shuki25/iot-playground-esp32/pdf/iot_playground.pdf

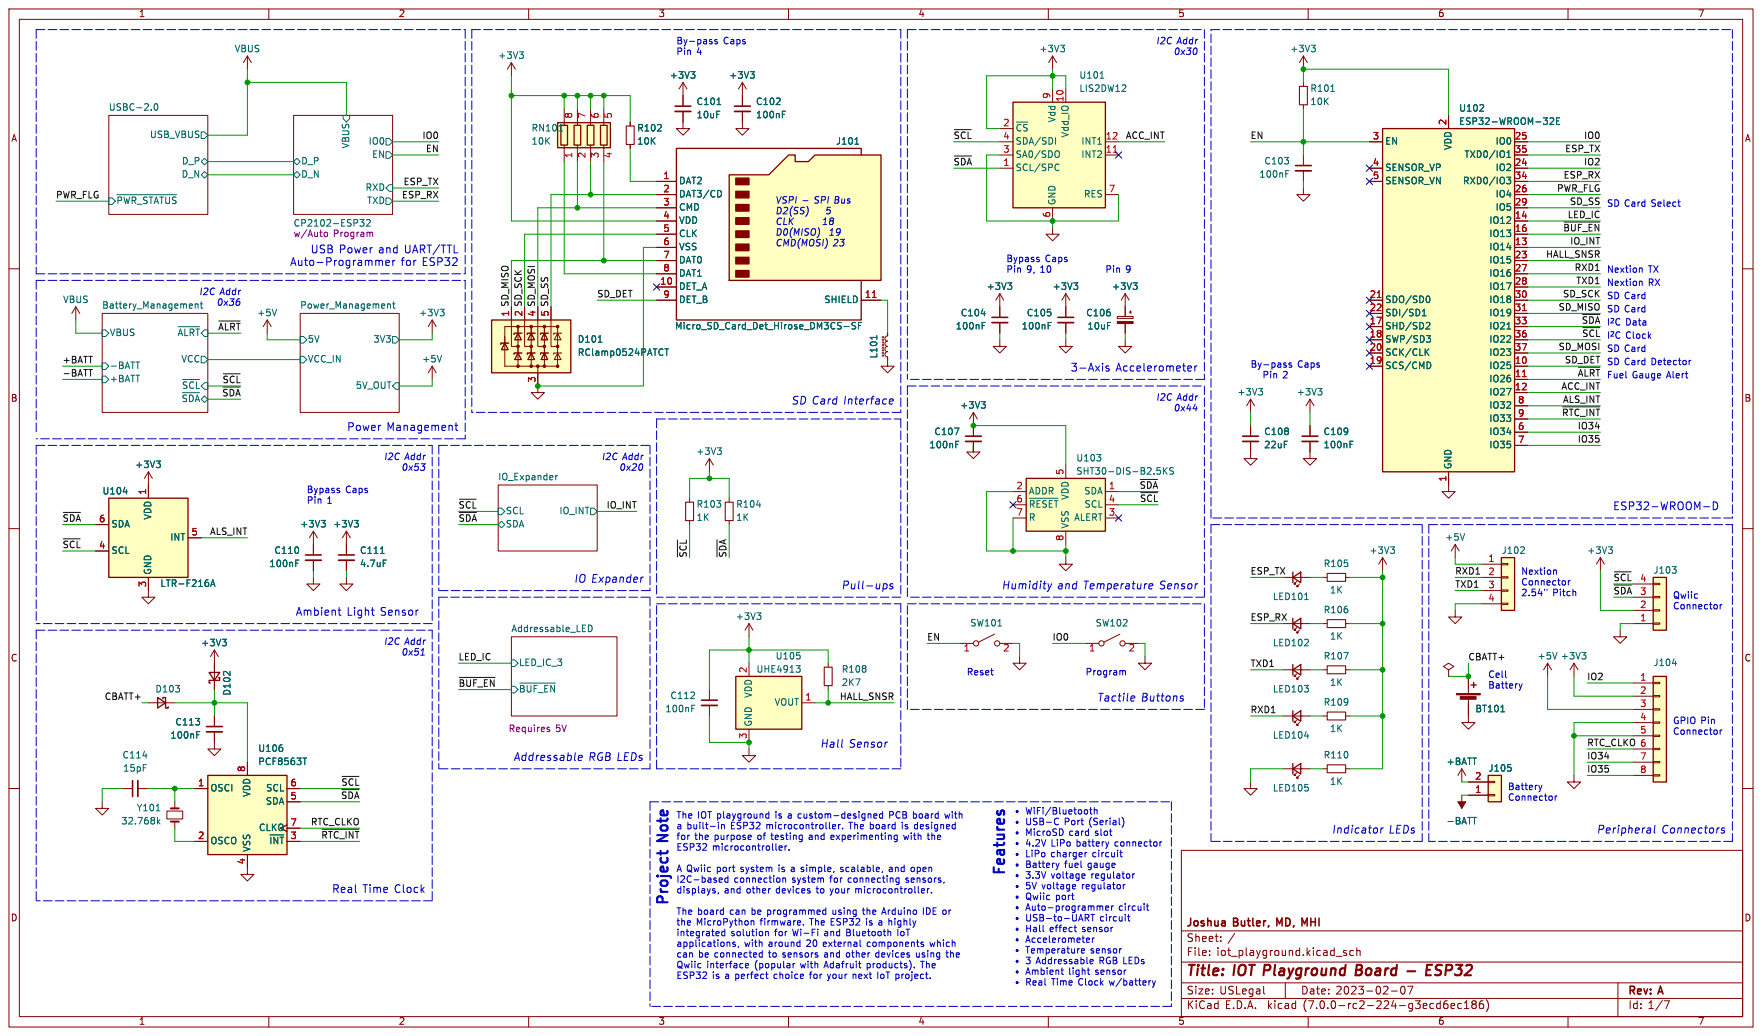
[picture p1: page 1]

4 SDA 5 SCL 6 CLKO 7 VDD

þÿ "WiFi/Bluetooth
þÿ "USB-C Port (Serial)
þÿ "MicroSD card slot þÿ "4.2V LiPo battery connector þÿ "LiPo charger circuit þÿ "Battery fuel gauge

Id: 1/7 Title: IOT Playground Board - ESP32

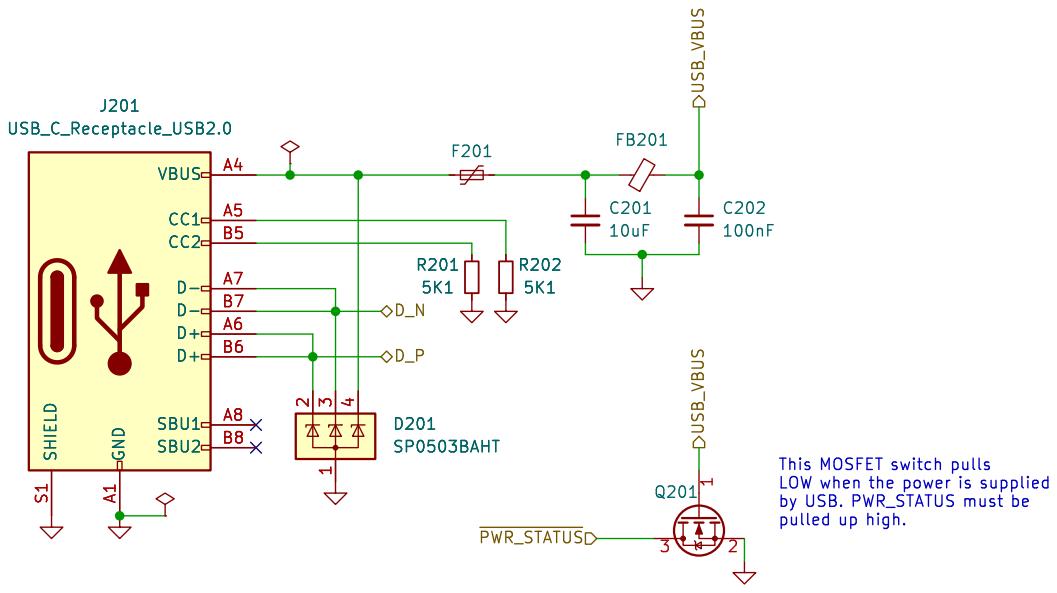
[picture p2: page 2]

This MOSFET switch pulls LOW when the power is supplied

by USB. PWR_STATUS must be

Id: 2/7 Title: USB-C 2.0 / Power and Data

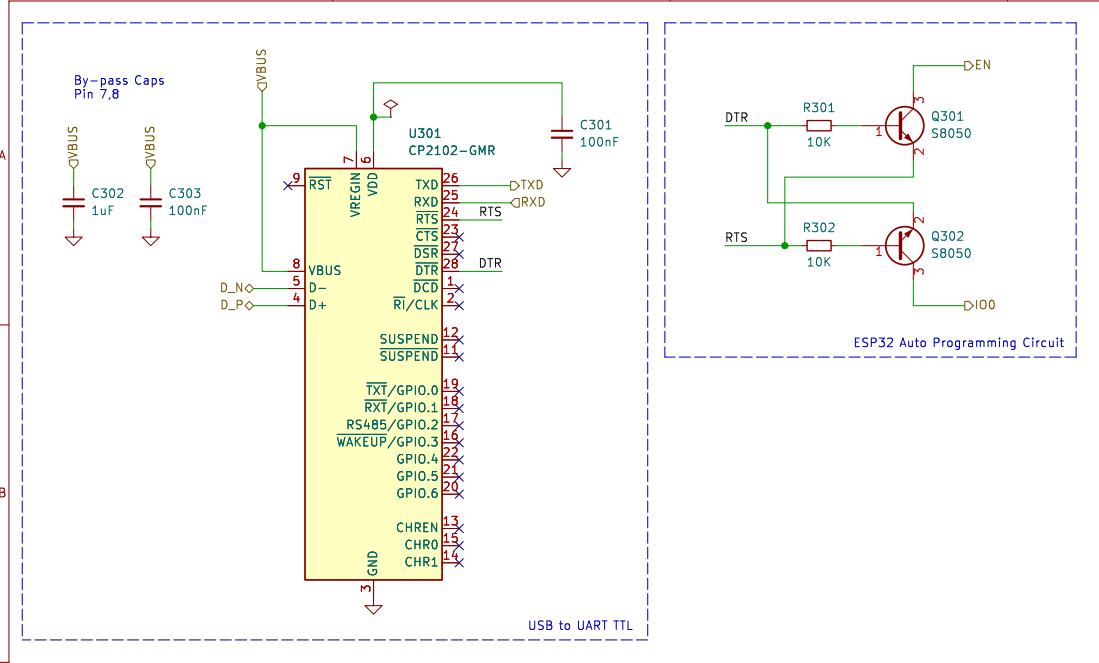
[picture p3: page 3]

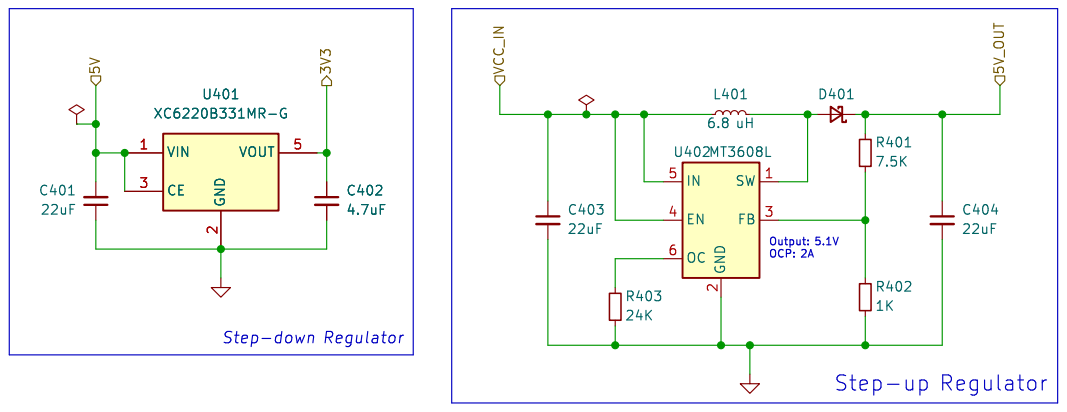
[picture p4: page 4]

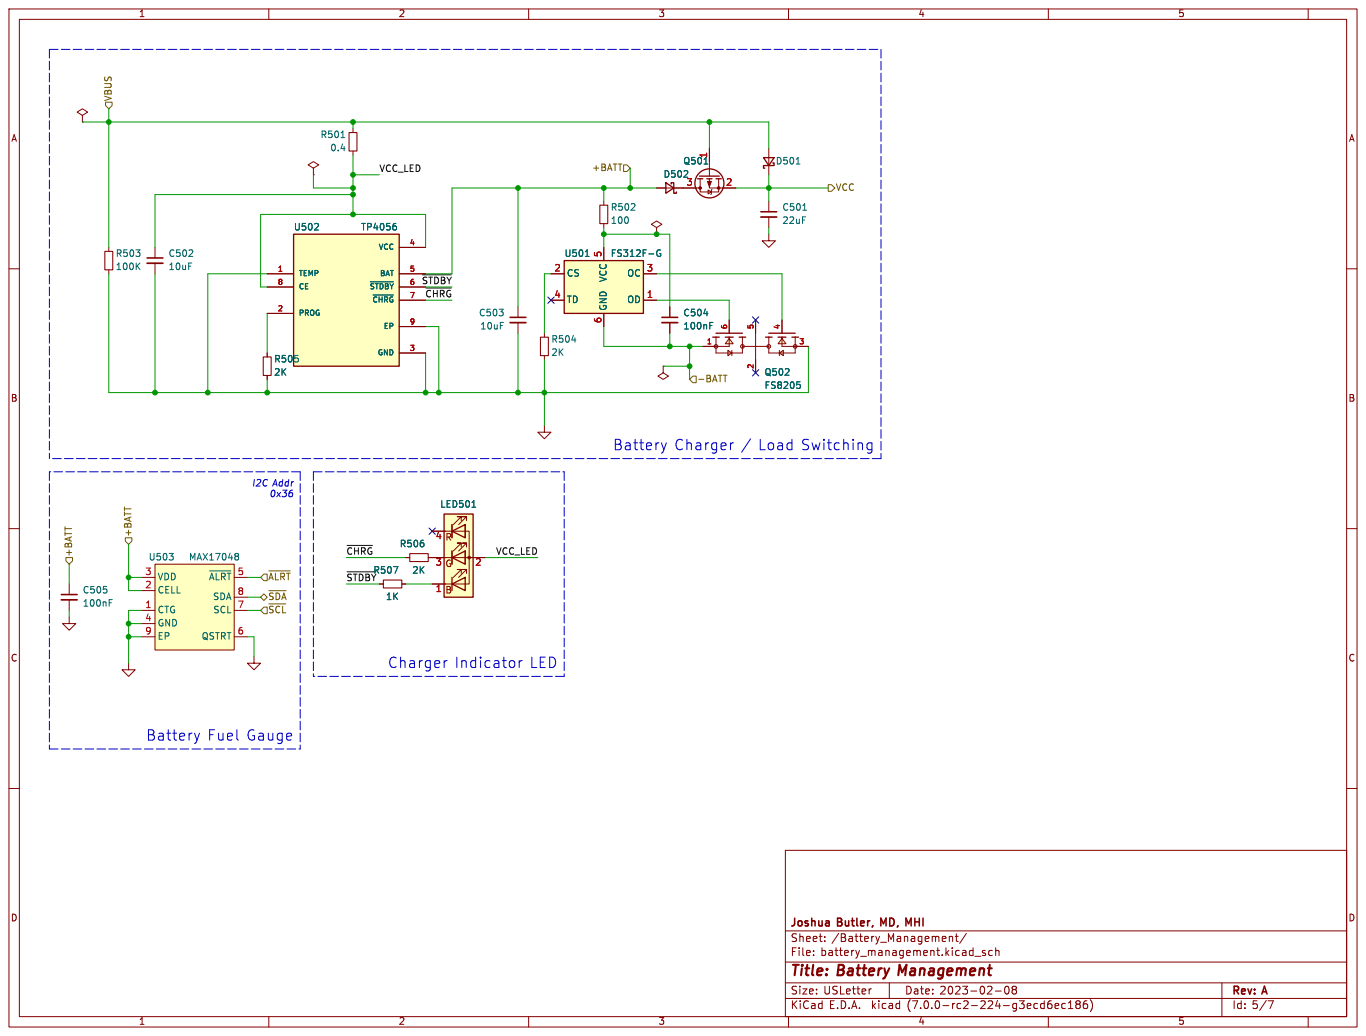
[picture p5: page 5]

4 Q502 FS8205 OD 1 CS 2 OC 3 TD 4 VCC

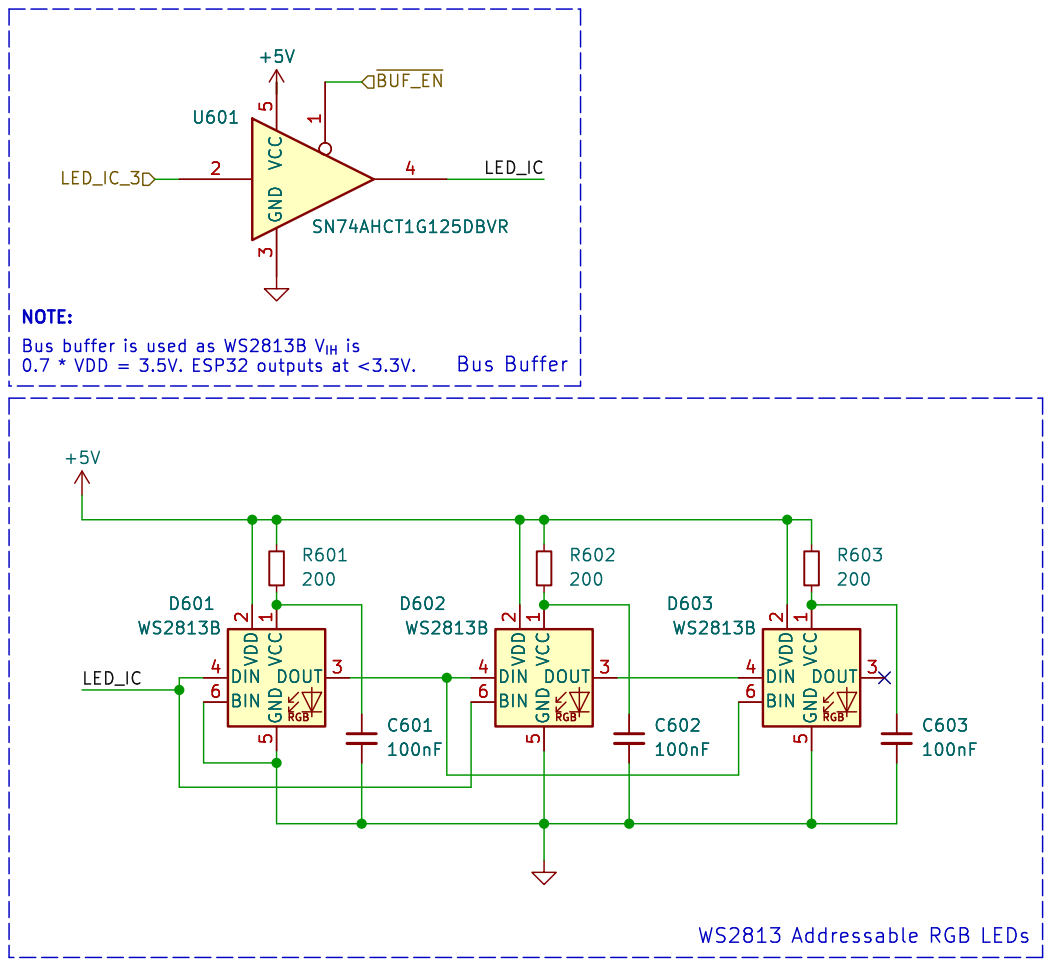
[picture p6: page 6]

Id: 6/7 Title: Addressable RGB LEDs

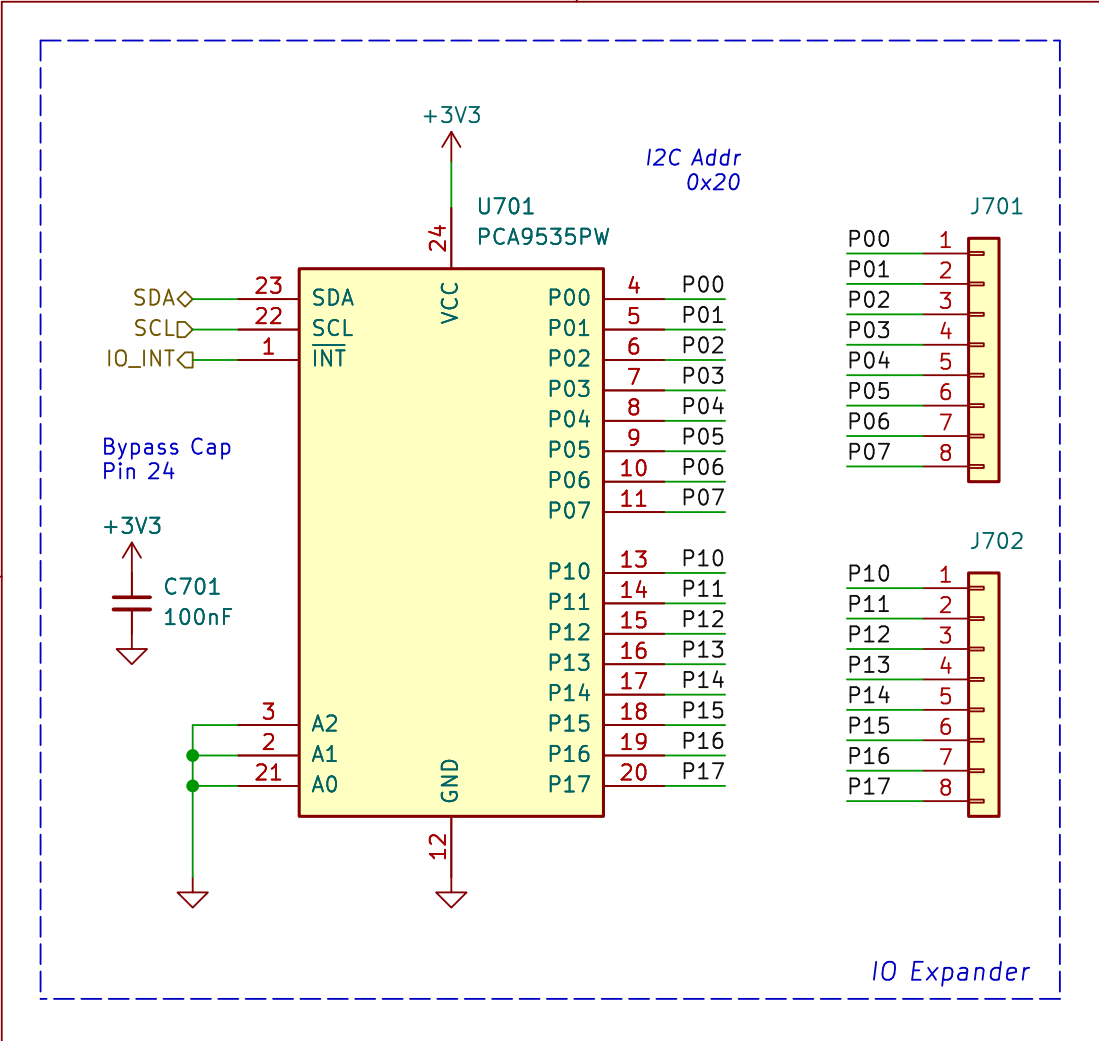
[picture p7: page 7]

I2C Addr 0x20 Bypass Cap Pin 24
