shuki25/iot-playground-esp32/iot_playground.kicad_pcb

## KiCad design iot_playground.kicad_pcb (2023-02-28)

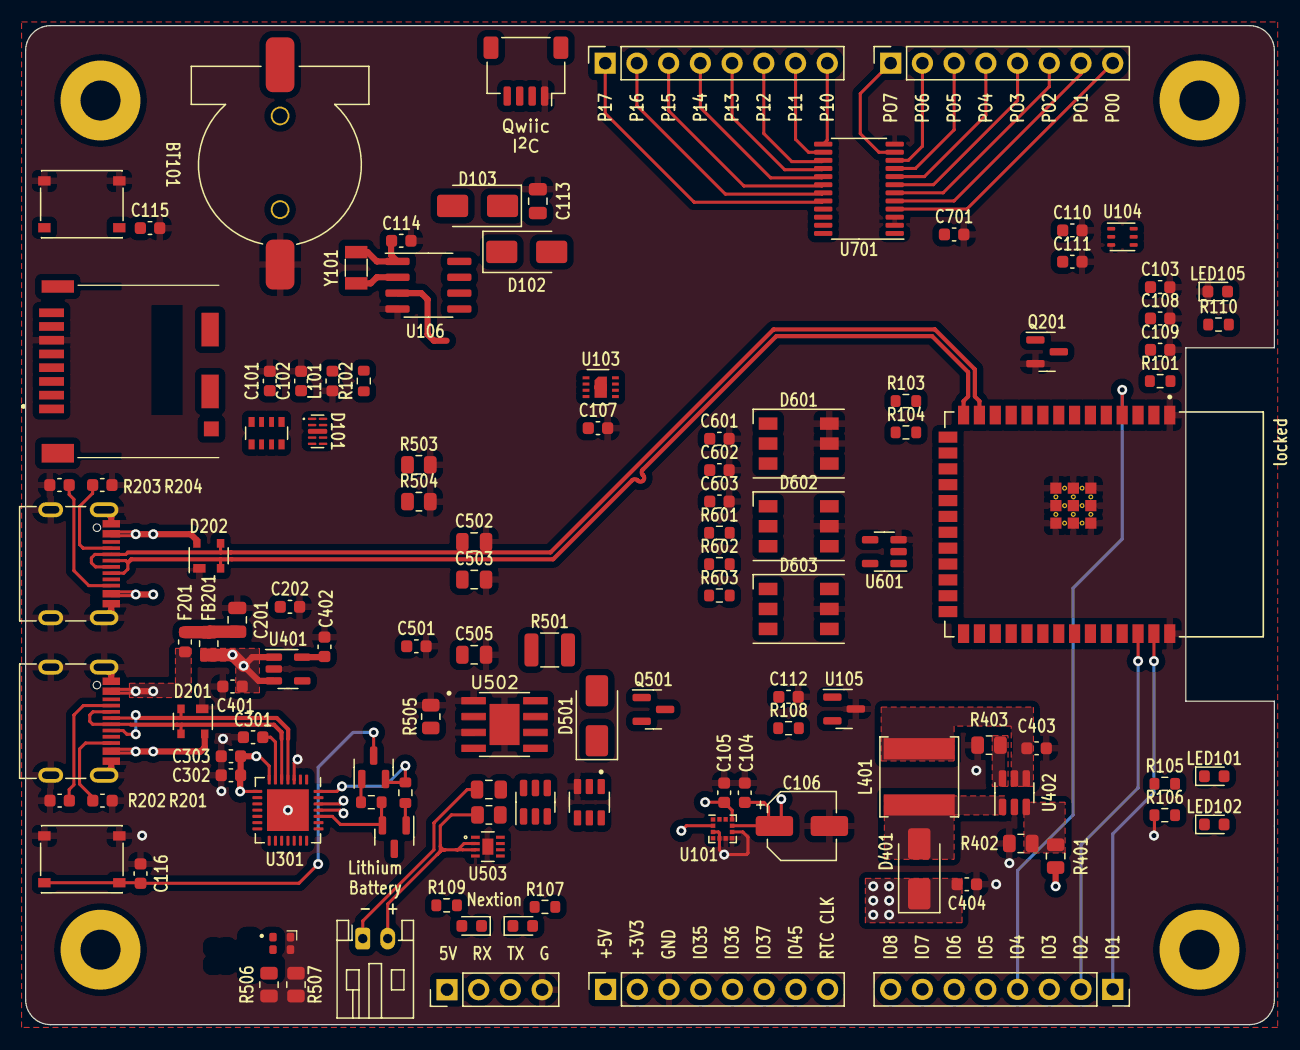
[picture p8: board iot_playground.kicad_pcb from above]

Board: 4 copper layers, 100.0 x 80.0 mm, 121 parts (0 on the bottom side), 104 nets.

Parts:
BT101: Battery_Cell; BatteryHolder_CR1220
C101, C108: 10uF; C_0603_1608Metric
C102, C104, C105, C107, C109, C110, C112, C115, C116, C202, C301, C303, C601, C602, C603, C701: 100nF; C_0603_1608Metric
C103, C302: 1uF; C_0603_1608Metric
C106: 10uF; CP_Elec_5x5.4
C111, C402: 4.7uF; C_0603_1608Metric
C113, C504, C505: 100nF; C_0805_2012Metric
C114: 15pF; C_0603_1608Metric
C201, C502, C503: 10uF; C_0805_2012Metric
C401, C403, C404, C501: 22uF; C_0603_1608Metric
D101: RClamp0524PATCT; SLP2510P8
D102, D103, D401, D501: D_Schottky; D_SMA
D201, D202: SP0503BAHT; SOT-143
D601, D602, D603: WS2813B; LED_WS2812_PLCC6_5.0x5.0mm_P1.6mm
F201: Polyfuse_Small; Fuse_0603_1608Metric
FB201: FerriteBead_Small; R_0805_2012Metric
H101, H102, H103, H104: MountingHole_Pad; MountingHole_3.2mm_M3_Pad
J101: Micro_SD_Card_Det_Hirose_DM3CS-SF; DM3CS-SF
J102: Conn_01x04; PinHeader_1x04_P2.54mm_Vertical
J103: Conn_01x04; JST_SH_SM04B-SRSS-TB_1x04-1MP_P1.00mm_Horizontal
J104, J106, J701, J702: Conn_01x08; PinSocket_1x08_P2.54mm_Vertical
J105: Conn_01x02; JST_PH_S2B-PH-K_1x02_P2.00mm_Horizontal
J201, J202: USB_C_Receptacle_USB2.0; USB_C_Receptable_918-418K2023S40001
L101: L_Ferrite_Small; L_0603_1608Metric
L401: 6.8 uH; L_6.0x6.0_H4.5
LED101, LED103: BLUE; LED_0603_1608Metric
LED102, LED104: GREEN; LED_0603_1608Metric
LED105: RED; LED_0603_1608Metric
LED501: LED_RAGB; LED-4_1.6x1.6x0.85P
Q201: Q_NMOS_GSD; SOT-23
Q301, Q302: S8050; SOT-23
Q501: Q_PMOS_DGS; SOT-23
Q502: FS8205; SOT95P280X145-6N
R101, R102, R301, R302: 10K; R_0603_1608Metric
R103, R104, R105, R106, R107, R109, R110: 1K; R_0603_1608Metric
R108: 2K7; R_0603_1608Metric
R201, R202, R203, R204: 5K1; C_0603_1608Metric
R401: 7.5K; R_0805_2012Metric
R402, R507: 1K; R_0805_2012Metric
R403: 24K; R_0805_2012Metric
R501: 0.4; R_1210_3225Metric
R502: 100; R_0805_2012Metric
R503: 100K; R_0805_2012Metric
R504, R505, R506: 2K; R_0805_2012Metric
R601, R602, R603: 200; R_0603_1608Metric
RN101: 10K; R_Array_Convex_4x0603
SW101, SW102: SW_SPST; XKB-Connectivity-TS-1187A-B-A-B
U101: LIS2DW12; LGA-12_2x2mm_P0.5mm
U103: SHT30-DIS-B2.5KS; Sensirion_DFN-8-1EP_2.5x2.5mm_P0.5mm_EP1.1x1.7mm
U104: LTR-F216A; Lite-On_LTR-303ALS-01
U105: UHE4913; SOT-23
U106: PCF8563T; SOIC-8_3.9x4.9mm_P1.27mm
U301: CP2102-GMR; QFN-28-1EP_5x5mm_P0.5mm_EP3.35x3.35mm
U401: XC6220B331MR-G; SOT-23-5
U402: MT3608L; SOT-23-6
U501: FS312F-G; SOT-23-6
U502: TP4056; SOP127P600X175-9N
U503: MAX17048; MAX17048G&plus_T10
U601: SN74AHCT1G125DBVR; SOT-23-5
U701: PCA9535PW; TSSOP-24_4.4x7.8mm_P0.65mm
Y101: 32.768k; Crystal_SMD_3215-2Pin_3.2x1.5mm
locked: ESP32-S3-WROOM-1-N8R2; ESP32-S3-WROOM

Connections:
+3V3: C101.1, C102.1, C104.1, C105.1, C106.1, C107.1, C108.1, C109.1, C110.1, C111.1, C112.1, C402.1, C701.1, D102.2 (A), J101.4 (VDD), J103.2, J104.2, R101.2, R102.2, R103.2, R104.2, R105.1, R106.1, R107.1, R108.1, R109.1, R110.1, RN101.5 (R4.2), RN101.6 (R3.2), RN101.7 (R2.2), RN101.8 (R1.2), U101.2 (~CS), U101.9 (Vdd), U101.10 (Vdd_IO), U103.5 (VDD), U104.1 (VDD), U105.2 (VDD), U401.5 (VOUT), U701.24 (VCC), locked.2 (3V3)
+5V: C202.1, C302.1, C303.1, C401.2, C404.1, D401.1 (K), D601.2 (VDD), D602.2 (VDD), D603.2 (VDD), FB201.2, J102.1, J104.1, Q201.1 (G), R401.1, R601.1, R602.1, R603.1, U301.7 (VREGIN), U301.8 (VBUS), U401.1 (VIN), U401.3 (CE), U601.5 (VCC)
+BATT: C503.1, C505.1, J105.2, Q501.3 (D), R502.1, U502.5 (BAT), U503.2 (CELL), U503.3 (VDD)
-BATT: C504.2, J105.1, Q502.1, U501.6 (GND)
/ACC_INT: U101.12 (INT1), locked.34 (IO41)
/ALS_INT: U104.5 (INT), locked.35 (IO42)
/Addressable_LED/LED_IC: D601.4 (DIN), D602.6 (BIN), U601.4
/Battery_Management/VCC: C403.1, C501.1, D501.1 (K), L401.1, Q501.2 (S), U402.4 (EN), U402.5 (IN)
/Battery_Management/VCC_LED: C502.1, LED501.2 (A), R501.2, U502.4 (VCC), U502.8 (CE)
/Battery_Management/~CHRG: R507.1, U502.7 (~CHRG)
/Battery_Management/~STDBY: R506.1, U502.6 (~STDBY)
/CBATT+: BT101.1 (+), D103.2 (A)
/CP2102-ESP32/DTR: Q302.2 (E), R301.2, U301.28 (~DTR)
/CP2102-ESP32/D_N: D201.3 (K), J201.A7 (D-), J201.B7 (D-), U301.5 (D-)
/CP2102-ESP32/D_P: D201.2 (K), J201.A6 (D+), J201.B6 (D+), U301.4 (D+)
/CP2102-ESP32/RTS: Q301.2 (E), R302.2, U301.24 (~RTS)
/EN: C103.1, C115.1, Q301.3 (C), R101.1, SW101.1 (A), locked.3 (EN)
/ESP_RX: LED102.1 (K), U301.26 (TXD), locked.36 (IO44/RXD0)
/ESP_TX: LED101.1 (K), U301.25 (RXD), locked.37 (IO43/TXD0)
/HALL_SNSR: R108.2, U105.1 (VOUT), locked.33 (IO40)
/IO0: C116.1, Q302.3 (C), SW102.1 (A), locked.27 (IO0*)
/IO1: J106.1, locked.39 (IO1)
/IO2: J106.2, locked.38 (IO2)
/IO3: J106.3, locked.15 (IO3*)
/IO4: J106.4, locked.4 (IO4)
/IO5: J106.5, locked.5 (IO5)
/IO6: J106.6, locked.6 (IO6)
/IO7: J106.7, locked.7 (IO7)
/IO8: J106.8, locked.12 (IO8)
/IO35: J104.4, locked.28 (^IO35)
/IO36: J104.5, locked.29 (^IO36)
/IO37: J104.6, locked.30 (^IO37)
/IO45: J104.7, locked.26 (*IO45)
/IO_Expander/P00: J701.8, U701.4 (P00)
/IO_Expander/P01: J701.7, U701.5 (P01)
/IO_Expander/P02: J701.6, U701.6 (P02)
/IO_Expander/P03: J701.5, U701.7 (P03)
/IO_Expander/P04: J701.4, U701.8 (P04)
/IO_Expander/P05: J701.3, U701.9 (P05)
/IO_Expander/P06: J701.2, U701.10 (P06)
/IO_Expander/P07: J701.1, U701.11 (P07)
/IO_Expander/P10: J702.8, U701.13 (P10)
/IO_Expander/P11: J702.7, U701.14 (P11)
/IO_Expander/P12: J702.6, U701.15 (P12)
/IO_Expander/P13: J702.5, U701.16 (P13)
/IO_Expander/P14: J702.4, U701.17 (P14)
/IO_Expander/P15: J702.3, U701.18 (P15)
/IO_Expander/P16: J702.2, U701.19 (P16)
/IO_Expander/P17: J702.1, U701.20 (P17)
/IO_INT: U701.1 (~INT), locked.32 (IO39)
/LED_IC: U601.2, locked.23 (IO21)
/PWR_FLG: Q201.3 (D), locked.8 (IO15/XTAL+)
/RTC_CLKO: J104.8, U106.7 (CLKO)
/RXD1: J102.2, LED104.1 (K), locked.11 (RXD1/IO18)
/SD_DET: J101.9 (DET_B), locked.24 (IO47)
/SD_MISO: D101.1 (K1), J101.7 (DAT0), RN101.4 (R4.1), locked.22 (IO14)
/SD_MOSI: D101.4 (K3), J101.3 (CMD), RN101.2 (R2.1), locked.21 (IO13)
/SD_SCK: D101.2 (K2), J101.5 (CLK), locked.20 (IO12)
/SD_SS: D101.5 (K4), J101.2 (DAT3/CD), RN101.3 (R3.1), locked.19 (IO11)
/TXD1: J102.3, LED103.1 (K), locked.10 (TXD1/IO17)
/USBC-2.0/USB_VCC: D201.4 (K), D202.4 (K), F201.1, J201.A4 (VBUS), J201.A9 (VBUS), J201.B4 (VBUS), J201.B9 (VBUS), J202.A4 (VBUS), J202.A9 (VBUS), J202.B4 (VBUS), J202.B9 (VBUS)
/USB_N: D202.3 (K), J202.A7 (D-), J202.B7 (D-), locked.13 (D-/IO19)
/USB_P: D202.2 (K), J202.A6 (D+), J202.B6 (D+), locked.14 (D+/IO20)
/~ALRT: U503.5 (~ALRT), locked.9 (IO16/XTAL-)
/~BUF_EN: U601.1, locked.31 (IO38)
/~RTC_INT: U106.3 (~INT), locked.25 (IO48)
/~SCL: J103.4, R103.1, U101.4 (SDA/SDI), U103.4 (SCL), U104.4 (SCL), U106.6 (SCL), U503.7 (SCL), U701.22 (SCL), locked.18 (IO10)
/~SDA: J103.3, R104.1, U101.1 (SCL/SPC), U103.1 (SDA), U104.6 (SDA), U106.5 (SDA), U503.8 (SDA), U701.23 (SDA), locked.17 (IO9)
GND: BT101.2 (-), C101.2, C102.2, C103.2, C104.2, C105.2, C106.2, C107.2, C108.2, C109.2, C110.2, C111.2, C112.2, C113.2, C114.1, C115.2, C116.2, C201.2, C202.2, C301.2, C302.2, C303.2, C401.1, C402.2, C403.2, C404.2, C501.2, C502.2, C503.2, C505.2, C601.2, C602.2, C603.2, C701.2, D101.3 (A), D201.1 (A), D202.1 (A), D601.5 (GND), D601.6 (BIN), D602.5 (GND), D603.5 (GND), J101.6 (VSS), J102.4, J103.1, J104.3, J201.A1 (GND), J201.A12 (GND), J201.B1 (GND), J201.B12 (GND), J201.S1 (SHIELD), J202.A1 (GND), J202.A12 (GND), J202.B1 (GND), J202.B12 (GND), J202.S1 (SHIELD), L101.1, LED105.1 (K), Q201.2 (S), Q502.3, R201.1, R202.1, R203.1, R204.1, R402.2, R403.2, R503.2, R504.2, R505.2, SW101.2 (B), SW102.2 (B), U101.3 (SA0/SDO), U101.5 (NC), U101.6 (GND), U101.7 (RES), U101.8 (GND), U103.2 (ADDR), U103.7 (R), U103.8 (VSS), U103.9 (VSS), U104.3 (GND), U105.3 (GND), U106.4 (VSS), U301.3 (GND), U301.29 (GND), U401.2 (GND), U402.2 (GND), U502.1 (TEMP), U502.3 (GND), U502.9 (EP), U503.1 (CTG), U503.4 (GND), U503.6 (QSTRT), U503.9 (EP), U601.3 (GND), U701.2 (A1), U701.3 (A2), U701.12 (GND), U701.21 (A0), locked.1 (GND), locked.40 (GND), locked.41_1 (GND), locked.41_2 (GND), locked.41_3 (GND), locked.41_4 (GND), locked.41_5 (GND), locked.41_6 (GND), locked.41_7 (GND), locked.41_8 (GND), locked.41_9 (GND)
unnamed: C301.1, U301.6 (VDD)
unnamed: C504.1, R502.2, U501.5 (VCC)
unnamed: C201.1, F201.2, FB201.1
unnamed: C113.1, D102.1 (K), D103.1 (K), U106.8 (VDD)
unnamed: D401.2 (A), L401.2, U402.1 (SW)
unnamed: D601.3 (DOUT), D602.4 (DIN), D603.6 (BIN)
unnamed: C601.1, D601.1 (VCC), R601.2
unnamed: D602.3 (DOUT), D603.4 (DIN)
unnamed: C602.1, D602.1 (VCC), R602.2
unnamed: C603.1, D603.1 (VCC), R603.2
unnamed: J101.8 (DAT1), RN101.1 (R1.1)
unnamed: J101.1 (DAT2), R102.1
unnamed: J101.11 (SHIELD), L101.2
unnamed: J201.A5 (CC1), R202.2
unnamed: J201.B5 (CC2), R201.2
unnamed: J202.A5 (CC1), R204.2
unnamed: J202.B5 (CC2), R203.2
unnamed: LED101.2 (A), R105.2
unnamed: LED102.2 (A), R106.2
unnamed: LED103.2 (A), R107.2
unnamed: LED104.2 (A), R109.2
unnamed: LED105.2 (A), R110.2
unnamed: LED501.3 (GK), R506.2
unnamed: LED501.4 (RK), R507.2
unnamed: Q301.1 (B), R301.1
unnamed: Q302.1 (B), R302.1
unnamed: C114.2, U106.1 (OSCI), Y101.1
unnamed: U106.2 (OSCO), Y101.2
unnamed: R401.2, R402.1, U402.3 (FB)
unnamed: R403.1, U402.6 (OC)
unnamed: R504.1, U501.2 (CS)
unnamed: Q502.4, U501.3 (OC)
unnamed: Q502.6, U501.1 (OD)
unnamed: R505.1, U502.2 (PROG)
VBUS: D501.2 (A), Q501.1 (G), R501.1, R503.1
