shuki25/iot-playground-esp32/(commit log)

2023-02-08 initial commit
    This reverts commit 54838efe01d276f115d3906eed4c397edf191dfc.
    [addressable_led.kicad_sch, battery_management.kicad_sch, cp2102-esp32-autoprogram.kicad_sch, cp2102.kicad_sch, io_expander.kicad_sch, iot_playground.kicad_pcb, iot_playground.kicad_sch, ldo_3V3.kicad_sch]
2023-02-09 add RTC, humidity and temp sensors
    updated footprint paths
    [battery_management.kicad_sch, io_expander.kicad_sch, iot_playground.kicad_sch]
2023-02-09 update LCSC parts and footprints
    [battery_management.kicad_sch, iot_playground.kicad_sch, power_management.kicad_sch]
2023-02-09 initial PCB
    [iot_playground.kicad_pcb]
2023-02-09 update schematic pdf
2023-02-09 update pcb
    [iot_playground.kicad_pcb]
2023-02-10 update 3d models
    [iot_playground.kicad_pcb, iot_playground.kicad_sch]
2023-02-13 revise schematics
    [battery_management.kicad_sch, io_expander.kicad_sch, iot_playground.kicad_sch, usbc-2-0.kicad_sch]
2023-02-13 update layout
    [iot_playground.kicad_pcb]
2023-02-13 update pcb layout
    [battery_management.kicad_sch, iot_playground.kicad_pcb, iot_playground.kicad_sch]
2023-02-28 update pcb design
    [iot_playground.kicad_pcb, iot_playground.kicad_sch]
